paavansankeerth05-beep/Low-IF-AM-Receiver-Transistor-Level-Analog-Baseband-in-LTspice/final_receiver.asc

B1: bv; V=V(rf)*V(loi)*0.5+1.2
B2: bv; V=V(rf)*V(loq)*0.5+1
B3: bv; V = 1.65 *(1+0.5*cos(2*pi*5k*time))*cos(2*pi*100k*time)
B4: bv; V=4*((V(vqlpf)-1)*cos(2*pi*10k*time-0.68)-(V(vilpf)-1.2)*sin(2*pi*10k*time-0.68))-1.65
B5: bv; V=sqrt(V(Vm)^2)
V1: voltage; SINE(0 0.825 5k 0 0 90 100)
V2: voltage; SINE(0 1 90k)
V3: voltage; SINE(0 1 90k 0 0 90)
X1: lowpassfilter
X2: lowpassfilter
Named nets: 0, loi, loq, Vilpf, vqlpf, rf, Vm, Vmre, test
.tran 0 2m 0 50n
