paavansankeerth05-beep/Low-IF-AM-Receiver-Transistor-Level-Analog-Baseband-in-LTspice/lowpassfilter.asc

C1: cap; 530p
C2: cap; 177p
C3: cap; 1.59n
R1: res; 10k
R2: res; 10k
R3: res; 10k
R4: res; 10k
R5: res; 10k
V1: voltage; 3.3
V2: voltage; 1.65
X1: low_if_reciever
X2: low_if_reciever
Named nets: 0, in, out
