paavansankeerth05-beep/Low-IF-AM-Receiver-Transistor-Level-Analog-Baseband-in-LTspice/low_if_reciever.asc

C1: cap; 0.1p
I1: current; 100µ
M1: nmos4; CMOSN; l=1u w=20u
M2: nmos4; CMOSN; l=1u w=20u
M3: nmos4; CMOSN; l=1u w=20u
M4: nmos4; CMOSN; l=1u w=20u
M5: pmos4; CMOSP; l=1u w=28u
M6: pmos4; CMOSP; l=1u w=28u
M7: nmos4; CMOSN; l=1u w=40u
M8: pmos4; CMOSP; l=1u w=112u
R1: res; 750
Named nets: 0, out, invin, noninvin, vcc
.model CMOSN NMOS (Level=1 Vto=0.6  Kp=120u Gamma=0.4 Phi=0.7 Lambda=0.04 Cgso=300p Cgdo=300p)
.model CMOSP PMOS (Level=1 Vto=-0.7 Kp=40u  Gamma=0.4 Phi=0.7 Lambda=0.05 Cgso=300p Cgdo=300p)
;.op
.ac dec 100 10 1000Meg
